LukeHuesman/Hot-Cocoa-Maker-BAE305/cocoa2.jpg

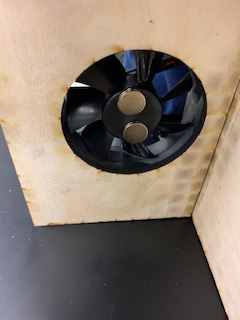
cocoa2.jpg
