LukeHuesman/Hot-Cocoa-Maker-BAE305/cocoa3.jpg

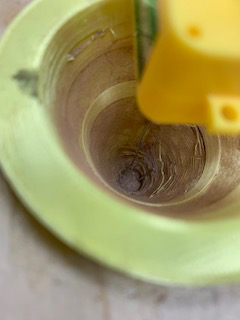
cocoa3.jpg
